tiger-14/GlintX/CAD files/Solidworks 2024 part files/Toplid.SLDPRT

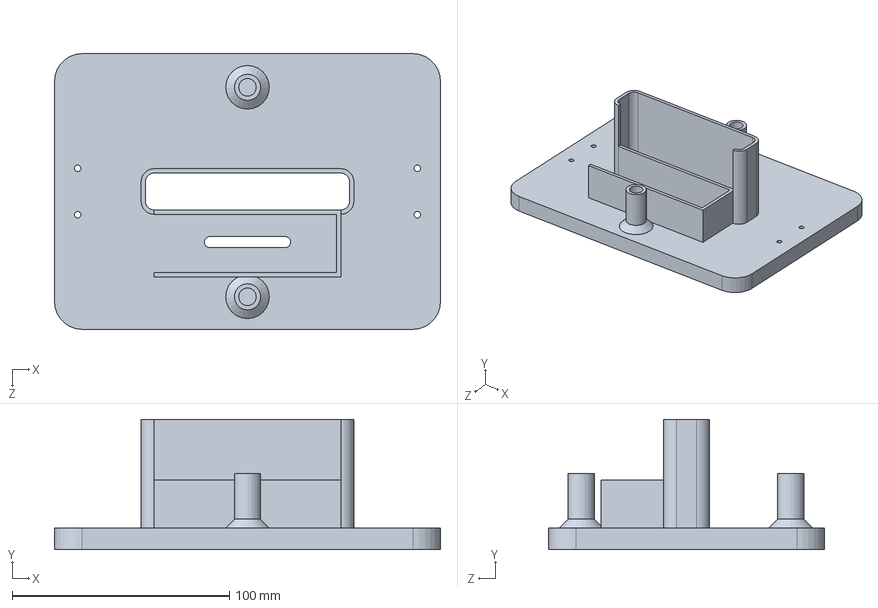
[picture p1: CAD file, 2026-06-28]
CAD files/Solidworks 2024 part files/Toplid.SLDPRT
177.8 x 60.0 x 127.0 mm
