tiger-14/GlintX/CAD files/STEP files/Shell.STEP

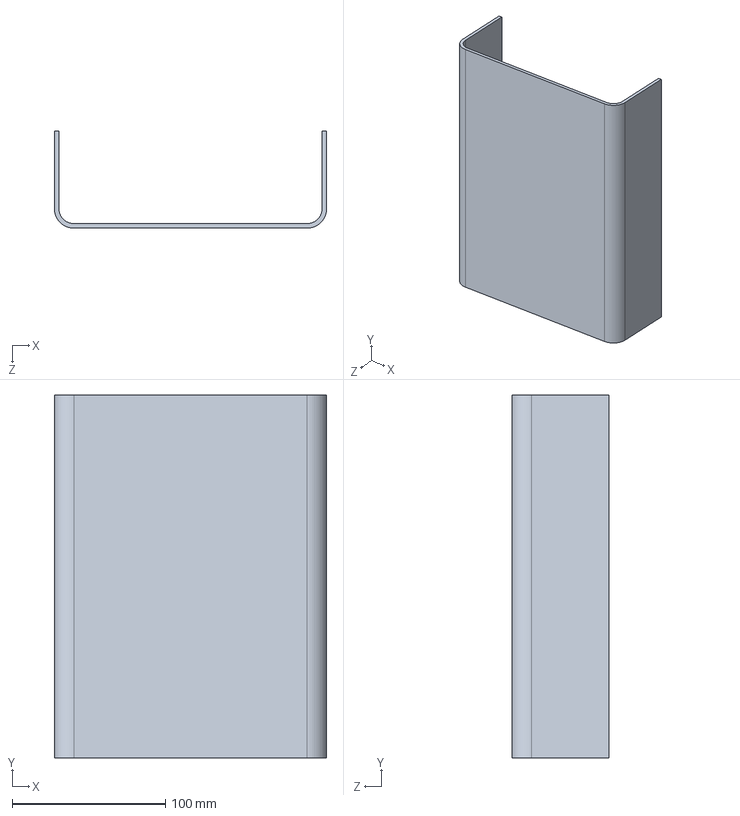
[picture p2: CAD file, 2026-06-28]
CAD files/STEP files/Shell.STEP
177.8 x 237.0 x 63.5 mm
