tiger-14/GlintX/CAD files/Solidworks 2024 part files/BottomBase.SLDPRT

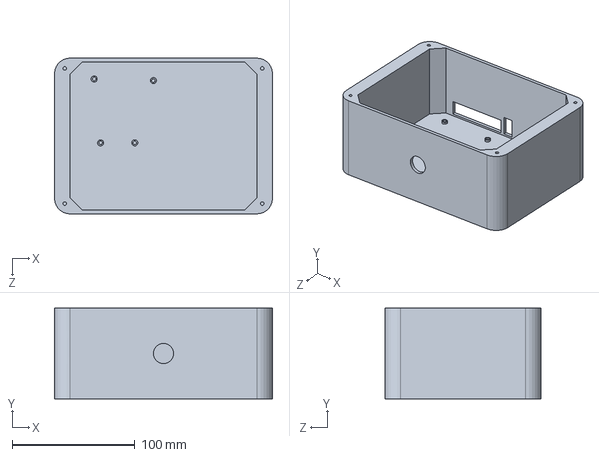
[picture p3: CAD file, 2026-06-28]
CAD files/Solidworks 2024 part files/BottomBase.SLDPRT
177.8 x 74.0 x 127.0 mm
