tiger-14/GlintX/CAD files/STEP files/Carriage.STEP

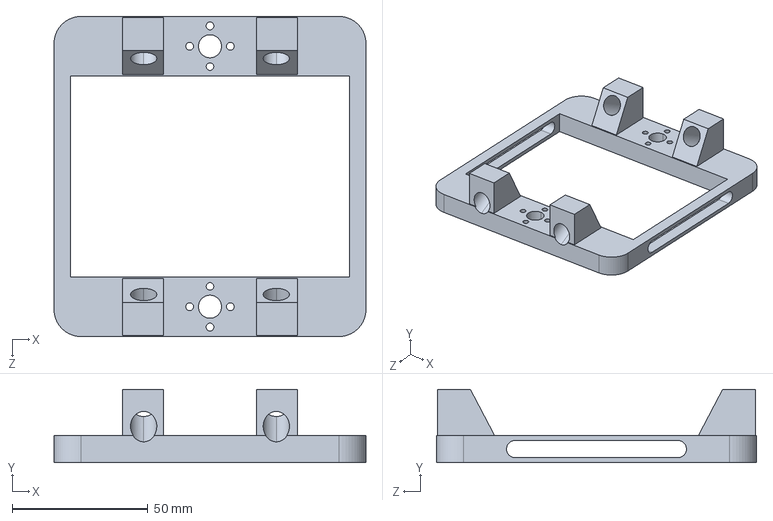
[picture p4: CAD file, 2026-06-28]
CAD files/STEP files/Carriage.STEP
115.0 x 27.0 x 118.0 mm
