tiger-14/GlintX/CAD files/Solidworks 2024 part files/MiddleBase.SLDPRT

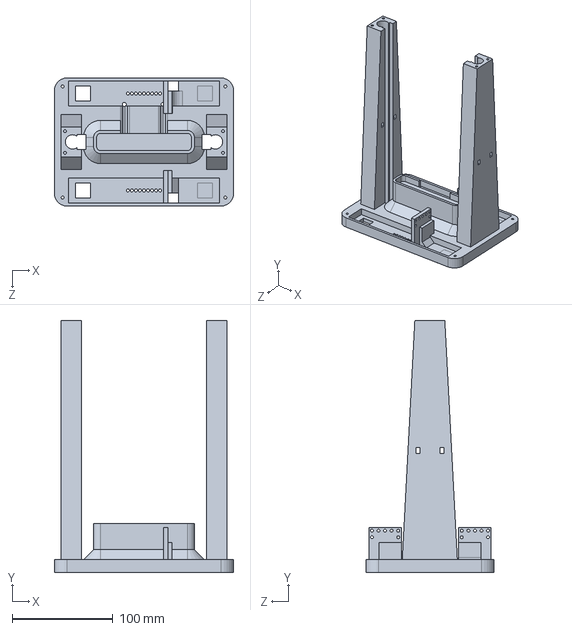
[picture p5: CAD file, 2026-06-28]
CAD files/Solidworks 2024 part files/MiddleBase.SLDPRT
177.8 x 249.7 x 127.0 mm
