tiger-14/GlintX/CAD files/Solidworks 2024 part files/Assembly.SLDASM

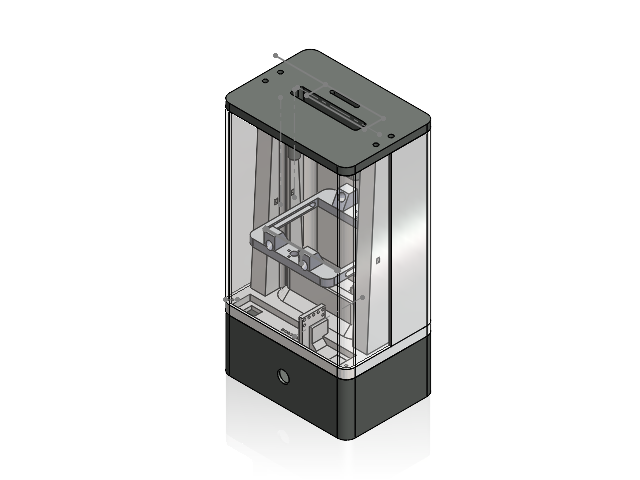
[picture p6: CAD file, 2026-06-28]
CAD files/Solidworks 2024 part files/Assembly.SLDASM
GlintXTTBaseV8
BottomBaseGlintXV1
CarriageGlintXV2
ShellGLINTXV1 x 2
ToplidGLINTXV1
