tiger-14/GlintX/(list of files, cad)

Other CAD files:
CAD files/Solidworks 2024 part files/Carriage.SLDPRT
CAD files/STEP files/Toplid.STEP
CAD files/Solidworks 2024 part files/Shell.SLDPRT
CAD files/STEP files/BottomBase.STEP
CAD files/STEP files/MiddleBase.STEP
CAD files/STL files/BottomBase.STL
CAD files/STL files/Carriage.STL
CAD files/STL files/MiddleBase.STL
CAD files/STL files/Shell.STL
CAD files/STL files/Toplid.STL
