tiger-14/GlintX/(commit log)

2026-06-28 Added step files
    added cad files in step format
    [BottomBase.STEP, Carriage.STEP, MiddleBase.STEP, Shell.STEP, Toplid.STEP]
2026-06-28 oragnized cad files into a folder
    [BottomBase.STEP, Carriage.STEP, MiddleBase.STEP, Shell.STEP, Toplid.STEP]
2026-06-28 Organized all CAD files into seperate folders
    [Assembly.SLDASM, BottomBase.SLDPRT, BottomBase.STEP, BottomBase.STL, Carriage.SLDPRT, Carriage.STEP, Carriage.STL, MiddleBase.SLDPRT]
2026-06-28 Insert product image in README
    Added an image to the README to enhance visual appeal.
2026-06-28 Update README with demo video and materials list
    Added live demo video link and updated product images with descriptions. Included a bill of materials with links and prices for components used in the project.
2026-06-28 Refactor Bill of Materials to markdown table format
    Updated the Bill of Materials section with a markdown table format for better readability and added a total cost.
2026-06-28 Completed the ReadME
    Added Bill of Materials section with updated links and prices. Corrected collaborator's name and included AI usage details.
